sotakaneko0808/BHA_Centrifuge/README.md

BioHackAcadamy Centrifuge

* Arduino Code
* Bill of Materials
* Fritzing wiring scheme
* Sketchup file
* Rotor design

Archive contains:

* 2015 BHA1 Design
* 2015 BHA2 Design

To Do:

* Slide lock on top
* Lever switch lid detector
* BHA Board scheme
