sotakaneko0808/BHA_Centrifuge/BoM.md

## Bill of Materials

Make sure you have an Arduino or equivalent microprocessor.

### Components that are needed without using a Biohack Board

No|Amount|Description|Supplier NL|Cost|Supplier Japan|Cost|
------------: | ------------: | :------------ | :------------ | ------------:| :----------- | ------------:
1|1|DC Brushless motor 800 RPM/V & Electronic Speed Controller|[HobbyKing](http://www.hobbyking.com/hobbyking/store/__40269__HobbyKing_Donkey_ST3511_810kv_Brushless_Power_System_Combo.html)|12.92
2|1|3.5mm connector|[HobbyKing](http://www.hobbyking.com/hobbyking/store/__18448__Female_XT60_connectors_5pcs_bag_GENUINE.html)|2.31
3|1|Rotary encoder|[iPrototype](https://iprototype.nl/products/components/buttons-switches/rotary-encoder-rgb), [Farnell](http://nl.farnell.com/alps/ec12e1240406/encoder-vertical-12mm-12det-12ppr/dp/2065052), [EOO](http://www.eoo-bv.nl/index.php?_a=viewProd&productId=9553)|0.60
4|1|Knob|[Farnell](http://nl.farnell.com/multicomp/cr-r4-7/knob-soft-touch-d-shaft-black/dp/1440012?ost=1440012)|0.23
5|1|Power switch|[iPrototype](https://iprototype.nl/products/components/buttons-switches/rocker-switch-large), [Farnell](http://nl.farnell.com/multicomp/mc34224-071-1601/switch-spdt-20a-250vac-blk-red/dp/1454382)
6|1|DC power jack|[EOO](http://www.eoo-bv.nl/index.php?_a=viewProd&productId=14342)|0.85
7|1|12V 5A Power supply|[Farnell](http://nl.farnell.com/ideal-power/66ms-00120500-s01-v/psu-12v-5a-earthed-output/dp/2112013), [EOO](http://www.eoo-bv.nl/index.php?_a=viewProd&productId=13247)|20.00
8|1|Push button|[iPrototype](https://iprototype.nl/products/components/buttons-switches/momentary-push-button)|0.55
9|1|10K resistor|[Farnell](http://nl.farnell.com/te-connectivity/cfr16j10k/resistor-carbon-10k-0-25w-5/dp/2329474), [EOO](http://www.eoo-bv.nl/index.php?_a=viewProd&productId=7016)|0.06
10|4|Rubber feet|[Conrad](https://www.conrad.nl/nl/toolcraft-elastische-buffer-zelfklevend-pd2104sw-x-h-10-mm-x-4-mm-zwart-1-stuks-401489.html)|0.08
11|1|Sheet of 45cm x 95cm 3mm MDF|Houthandel Schmidt|
12|1|5mm shaft adapter|[HobbyKing](http://www.hobbyking.com/hobbyking/store/__44353__Prop_adapter_to_suit_5_0mm_motor_shaft_collet_EU_warehouse_.html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)|
13|1|Infrared sensor|[Farnell](http://nl.farnell.com/fairchild-semiconductor/qrd1114/opto-switch-reflective/dp/1467858?Ntt=1467858)|1.70
14|1|6.8 KOhm resistor|[Farnell](http://nl.farnell.com/multicomp/mcf-0-25w-6k8/resistor-carbon-film-6k8-0-25w/dp/9339663?Ntt=9339663)|0.02
15|1|220 Ohm resistor|[Farnell](http://nl.farnell.com/multicomp/mcf-0-25w-220r/resistor-carbon-film-220r-0-25w/dp/9339299?Ntt=9339299)|0.02
16|1|I2C LCD display|[iPrototype](https://iprototype.nl/products/components/led-lcd/lcd16x2-I2C-BL), ([HobbyElectronica](http://www.hobbyelectronica.nl/product/hd44780-16x2-karakters-lcd-display-module-blauw-backlight/) + [HobbyElectronica](http://www.hobbyelectronica.nl/product/i2c-lcd-interface-voor-16x2-en-20x4-displays/))|16.95
|17|2|10K resistor|[Farnell](http://nl.farnell.com/te-connectivity/cfr16j10k/resistor-carbon-10k-0-25w-5/dp/2329474), [EOO](http://www.eoo-bv.nl/index.php?_a=viewProd&productId=7016)|0.12
|18|2|10nF capacitor|[EOO](http://www.eoo-bv.nl/index.php?_a=viewProd&productId=5695)|0.2
|19|2|100nF capacitor|[EOO](http://www.eoo-bv.nl/index.php?_a=viewProd&productId=13443)|0.24

### Components that are needed on top of the Biohack Board

No|Amount|Description|Supplier NL|Cost
------------: | ------------: | :------------ | :------------ | ------------:
1|1|DC Brushless motor 800 RPM/V & Electronic Speed Controller|[HobbyKing](http://www.hobbyking.com/hobbyking/store/__40269__HobbyKing_Donkey_ST3511_810kv_Brushless_Power_System_Combo.html)|12.92
2|1|3.5mm connector|[HobbyKing](http://www.hobbyking.com/hobbyking/store/__18448__Female_XT60_connectors_5pcs_bag_GENUINE.html)|2.31
3|1|Rotary encoder|[iPrototype](https://iprototype.nl/products/components/buttons-switches/rotary-encoder-rgb), [Farnell](http://nl.farnell.com/alps/ec12e1240406/encoder-vertical-12mm-12det-12ppr/dp/2065052), [EOO](http://www.eoo-bv.nl/index.php?_a=viewProd&productId=9553)|0.60
4|1|Knob|[Farnell](http://nl.farnell.com/multicomp/cr-r4-7/knob-soft-touch-d-shaft-black/dp/1440012?ost=1440012)|0.23
5|1|Power switch|[iPrototype](https://iprototype.nl/products/components/buttons-switches/rocker-switch-large), [Farnell](http://nl.farnell.com/multicomp/mc34224-071-1601/switch-spdt-20a-250vac-blk-red/dp/1454382)
6|1|DC power jack|[EOO](http://www.eoo-bv.nl/index.php?_a=viewProd&productId=14342)|0.85
7|1|12V 5A Power supply|[Farnell](http://nl.farnell.com/ideal-power/66ms-00120500-s01-v/psu-12v-5a-earthed-output/dp/2112013), [EOO](http://www.eoo-bv.nl/index.php?_a=viewProd&productId=13247)|20.00
8|1|Push button|[iPrototype](https://iprototype.nl/products/components/buttons-switches/momentary-push-button)|0.55
9|4|Rubber feet|[Conrad](https://www.conrad.nl/nl/toolcraft-elastische-buffer-zelfklevend-pd2104sw-x-h-10-mm-x-4-mm-zwart-1-stuks-401489.html)|0.08
10|1|Sheet of 45cm x 95cm 3mm MDF|Houthandel Schmidt|
11|1|5mm shaft adapter|[HobbyKing](http://www.hobbyking.com/hobbyking/store/__44353__Prop_adapter_to_suit_5_0mm_motor_shaft_collet_EU_warehouse_.html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)|
12|1|Infrared sensor|[Farnell](http://nl.farnell.com/fairchild-semiconductor/qrd1114/opto-switch-reflective/dp/1467858?Ntt=1467858)|1.70
13|1|6.8 KOhm resistor|[Farnell](http://nl.farnell.com/multicomp/mcf-0-25w-6k8/resistor-carbon-film-6k8-0-25w/dp/9339663?Ntt=9339663)|0.02
14|1|220 Ohm resistor|[Farnell](http://nl.farnell.com/multicomp/mcf-0-25w-220r/resistor-carbon-film-220r-0-25w/dp/9339299?Ntt=9339299)|0.02
15|1|I2C LCD display|[iPrototype](https://iprototype.nl/products/components/led-lcd/lcd16x2-I2C-BL), ([HobbyElectronica](http://www.hobbyelectronica.nl/product/hd44780-16x2-karakters-lcd-display-module-blauw-backlight/) + [HobbyElectronica](http://www.hobbyelectronica.nl/product/i2c-lcd-interface-voor-16x2-en-20x4-displays/))|16.95

* As a rotor we wil use a 3D print of your own design, or this [Microfuge 8 Place Rotor](http://www.thingiverse.com/thing:97524)
* You will also need some M3 10 mm bolts and nuts

**Alternatives**

* Hard drive motors also speed up to about 7400 RPM, but if you choose to use this you will have to change the entire design
