sotakaneko0808/BHA_Centrifuge/README_Pieters-MacBook-Air-Waag_Sep-21-215256-2015_Conflict.md

BioHackAcadamy Centrifuge

* Arduino Code
* Bill of Materials
* Fritzing wiring scheme
* Sketchup file
* Rotor design

Archive contains:

* BHA 2015-1 "BioFactory" Design
