sotakaneko0808/BHA_Centrifuge/rotor/8 Place Rotor.stl

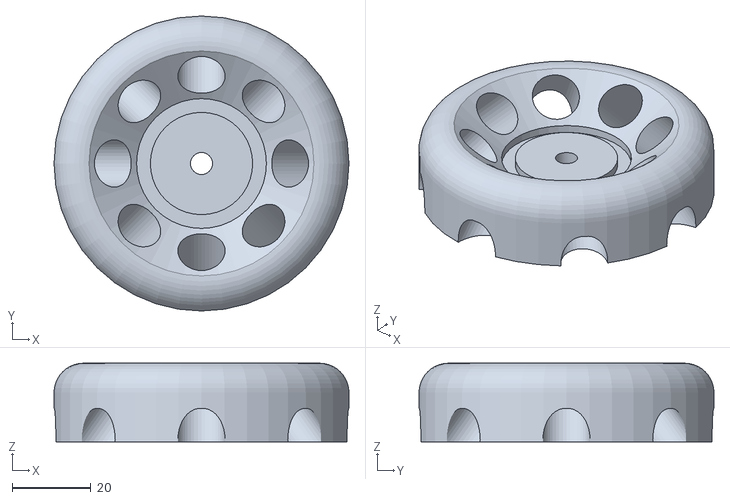
[picture p6: CAD file, 2015-03-09]
rotor/8 Place Rotor.stl
75.0 x 75.0 x 20.0
