sotakaneko0808/BHA_Centrifuge/(list of files, cad)

Other CAD files:
rotor/8 Place Rotor.scad
Archive/2015 BHA2/rotor/8 Place Rotor.scad
Archive/2015 BHA1/Centrifuge-Sketchup.skp
Archive/2015 BHA2/Centrifuge-Sketchup.skp
Centrifuge-Sketchup.skp
Centrifuge-Sketchup_MacBook-Waag_Mar-09-160447-2015_Conflict.skp
