sotakaneko0808/BHA_Centrifuge/(list of files, drawings)

Other design files:
Archive/2015 BHA1/Centrifuge-Fritzing.fzz
Archive/2015 BHA2/Centrifuge-Fritzing.fzz
Centrifuge-Fritzing.fzz
