sotakaneko0808/BHA_Centrifuge/(commit log)

2015-03-02 Copy from main repository
    [Centrifuge-Fritzing.fz, Centrifuge-Fritzing.fzz, Centrifuge-Sketchup.skp]
2015-03-03 Deleted old Fritzing file
    [Centrifuge-Fritzing.fz]
2015-03-09 Fixed Eppendorfs bumping into the RPM sensor
    [Centrifuge-Sketchup~.skp]
2015-03-09 Rotor update
    [8 Place Rotor.scad, Centrifuge-Sketchup_MacBook-Waag_Mar-09-160447-2015_Conflict.skp]
2015-03-23 Centrifuge file conflict resolved
    [Centrifuge-Sketchup.skp, Centrifuge-Sketchup~.skp]
2015-06-30 Archive BHA1
    [8 Place Rotor.scad, 8 Place Rotor.stl, Centrifuge-Fritzing.fzz, Centrifuge-Sketchup.skp]
2015-09-02 script and fritzing
    [Centrifuge-Fritzing.fzz]
2015-09-09 BoM update
2015-09-09 Update BoM
2015-10-27 fixed prop adapter link
2016-02-10 updating pins
    [Centrifuge-Fritzing.fzz]
2016-03-06 SVG export
    [Centrifuge-Sketchup.skp]
